NicoBWin/TPF-MA/README.md

# TPF-MA
Código implementado para el trabajo final de materia de 31.99 - Mecatrónica Aplicada

Informe: [Trabajo Final de Materia](Documentacion/Informe-TPF-G6.pdf)
