NicoBWin/TPF-MA/Documentacion/INSTRUCCIONES.pdf

### INSTRUCCIONES:

1. Conectar el dispositivo al cargador de celular y el mismo emitirá una señal de WiFi
2. Conectarse al WiFi del dispositivo según corresponda
a. “INERTIA-1” o “FREEFALL-1”
3. Ingresar la contraseña: 123456789
4. Abrir el navegador de preferencia (Ejemplo: Google Chrome) e ingresar en la barra superior el numero: 192.168.1.1

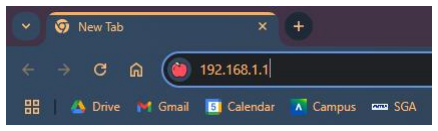
[picture p30: figure]

5. Cuando termina de cargar la página web correctamente, que es cuando se observa una línea azul clara horizontal en cero, se puede comenzar con las mediciones:
a. PLAY: Comienza las mediciones de un periodo de 15s aprox.
b. RESET: Reinicia las mediciones a 0.
c. Descargar PNG: Para descargar solo el grafico en formato PNG.
d. Descargar CSV: Para descargar todas las muestras adquiridas en formato CSV.
6. Para finalizar, desconectar el dispositivo del cargador de celular y el mismo, solo se apagará.

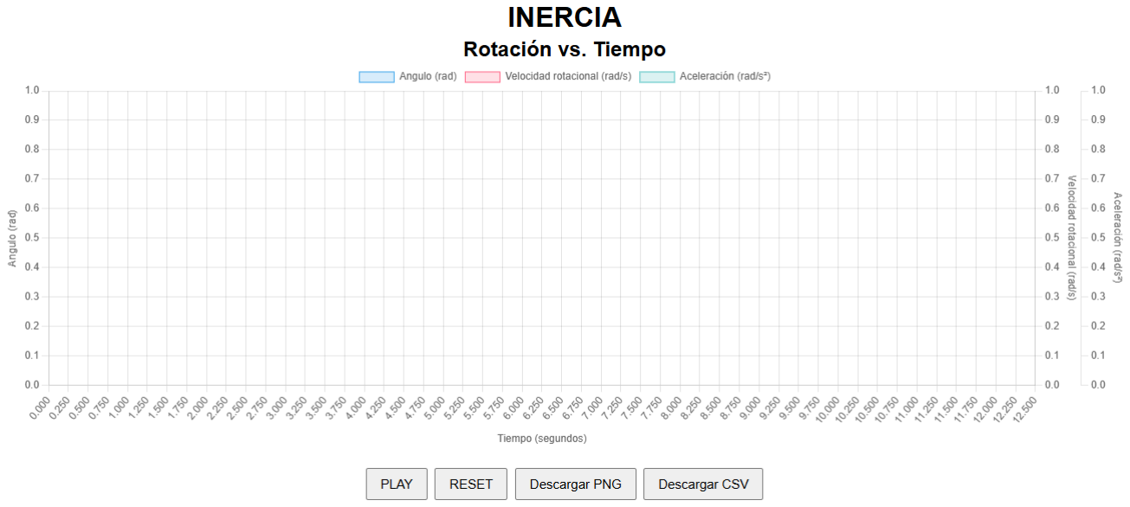
[picture p31: figure]

Página web de INERTIA-1.
