NicoBWin/TPF-MA/(commit log)

2024-11-15 Update on inertia
    Change sample on inertia to 5ms
    Add speed an acceleration on graph
2024-11-15 add filtering but it is not ready yet
2024-11-16 Inertia Done
    - Make graph bigger
    - Filter speed and acceleration
    - Change interval send data
